nikolay-rogovoy/3x-CNC/проверка-спецификации.md

# Проверка спецификации v1.0

> **Архивный документ.** Замечания закрыты в спецификации v2.0. Решения этого документа по компонентам (MGN12, шпиндель Ø65, труба 80×40×4) заменены: актуальны `спецификация.md` и `чертёж-станка.dxf`.

**Дата:** 2026-11-07. Проверялась спецификация v1.0.

Как проверялось:

- **Расчёт** — посчитано по числам спецификации или модели чертежа.
- **Источник** — подтверждено каталогом или листингом (ссылки в конце).
- **Оценка** — инженерная оценка или данные по памяти; перед заказом сверить.

## A. Критично: станок в таком виде не собрать или он не выполнит требования

| # | Где | Проблема | На чертеже | Основание |
|---|---|---|---|---|
| A1 | §3.1 | Стойки разнесены на 260–300 мм, а стол шириной 300 мм: портал не пройдёт над столом | Просвет между стойками 400 мм | Расчёт |
| A2 | §8.1 п.2, 6, 8 | Балка 420 мм короче своего рельса 450 мм и винта 500 мм | Балка 480, рельс 450, винт ≈520 | Расчёт |
| A3 | §2, §3.1 | Габарит ~450×370 меньше собственной базы 520×340 и рельсов Y 500 мм | Габарит 588×621×577 мм | Расчёт по модели |
| A4 | §3.2, §8.1 п.8 | Один винт Y возможен только по центру, а поперечина к гайке под столом лишает стол опор на участке хода. Старый чертёж при этом показывал два винта | Два винта и два мотора Y, стол опирается на балки поз. 3 | Расчёт; решение на согласование |
| A5 | §3.3 | Балка 20×80 не проходит критерий 50 Н → ≤0,05 мм: профиль с открытыми пазами слабо работает на кручение. Кончик фрезы смещается примерно на **0,45 мм**, в 9 раз больше допуска. 40×80 тоже не проходит: ≈0,22 мм. Эпоксид или песок в полости это не исправят | Закрытая труба Al 80×40×4: ≈0,013 мм | Оценка (см. раздел D) |
| A6 | §2, §4.1, §5.3 | 800 Вт при 24 В — это 33 А, а заложено 15–20 А; БП 24 В 20 А даёт только 480 Вт | Шпиндель с ЧП 220 В | Расчёт |
| A7 | §4.1 | Выбранного шпинделя (DC 24 В, 800 Вт, Ø52–57, до 24 000 об/мин) в поиске не нашлось. Найдены два класса: 800 Вт, Ø65, 220 В с ЧП, до 24 000 об/мин; или Ø52, 48 В, 500 Вт, только 12 000 об/мин, что ниже нужных для плат 18 000–24 000 | Посадка диам. 65 | Источник (листинги) |
| A8 | §3.2, §8.1 п.10 | Муфты 5×5 и 5×8 не подходят: у NEMA 23 вал обычно 6,35 или 8 мм, а наборы SFU1605 с BK/BF комплектуются муфтой 6,35×10 | Муфта 8×10, размер уточнить по валу | Источник |
| A9 | §3.1, §3.2 | Параллельность ≤0,03 мм нереальна при установке рельса прямо на необработанный профиль и выверке «шаблоном и уровнем» | Посадочные полосы поз. 5, шлифовать или фрезеровать | Оценка |
| A10 | §3.3, §8.1 п.7 | Ось Z описана тремя способами: «1–2 рельса», «ШВП по обе стороны от шпинделя», «рельс + вал Ø20». Это противоречит и «единому решению MGN12», и BOM (1 рельс). Один рельс плохо держит кручение | 2 рельса, 4 каретки, винт между рельсами | Расчёт |

## B. Важно: исправить до заказа

| # | Где | Проблема | Рекомендация |
|---|---|---|---|
| B1 | §8.1 | **Ошибка суммы:** механика 42 600 ₽, а не 37 200 ₽. Итог по текущему BOM **82 700 ₽, а не 77 300 ₽** (Расчёт) | Исправить и пересчитать BOM под новую компоновку |
| B2 | §2 | Питание ≤1000 Вт не выполняется: 600 Вт + 800 Вт = 1400 Вт | Поднять лимит до ≈1,5 кВт, подобрать автомат |
| B3 | §5.1, §5.3 | 48 В и плата 6-Pack: по сообщению на форуме предел платы около 40 В, на шелкографии указано 9–24 В. Это не официальные данные | Проверить по вики платы; либо 36 В, либо внешние драйверы |
| B4 | §5.2, §8.3 | Момент моторов расходится: 1,2–2,2 Н·м и 2–3 Н·м. 1,9 Н·м — это уже корпус 76 мм (Источник). Данных по 57HS41 и 57HS56 не нашёл | Запросить паспорт; чертёж рассчитан на корпус 56 мм, для 76 мм добавить 20 мм к габариту |
| B5 | §5.2, §5.3 | TMC2209 не потянет NEMA 23 на 2,8–4 А: предел около 2 А RMS. У модулей TMC5160 предел тоже бывает около 3 А (Оценка) | Убрать альтернативу с TMC2209; сверить ток с модулем |
| B6 | §3.2, §8.1 | «SFU1605 + double-nut» — противоречие: двойная гайка это DFU, а «завальцованные» здесь не имеет смысла. Нашёл SFU1605 только как катаный C7; C5 не подтвердился. Цена ≈2200 ₽ за C5 выглядит заниженной | Выбрать DFU или SFU с преднатягом; определить реальный класс |
| B7 | §3.2, §8.1 п.5 | Рельс Y 500 мм избыточен: при 400 мм запас хода 254,6 мм на 200 мм поля (Расчёт). Каретки: «2 на сторону» и «4 на рельс» расходятся | Рельс 400, по 2 каретки на рельс |
| B8 | §3.1 | «20×80, паз 8» и «30×80»: у 20-й серии обычно паз 6, 30×80 в поиске не встретился. 40×80 с пазом 8 есть в каталоге | На чертеже 40×80 паз 8; сверить с поставщиком |
| B9 | §8.1 | BOM не соответствует конструкции: стойки 350 при нужных 221; нет поперечин базы; один винт Y; один рельс Z; 3 мотора и 3 драйвера | Обновить; список ниже |
| B10 | §8 | Дубли: два п.29, цанги в п.15 и п.16, материал стола в п.12 и п.31 | Перенумеровать, убрать дубли |
| B11 | §3.2 | У Z нет места под BF12: опора попала бы в плиту. На чертеже винт Z консольный, только BK12, длина ≈205 мм | Подтвердить решение. ШВП не самотормозит: при снятии питания проверить, не опускается ли голова |
| B12 | §2 | Масса по модели ≈41 кг (грубая оценка с запасом) — на границе лимита 35–40 кг | Уточнить после деталировки |

## C. Мелкие противоречия и текст

- Параллельность: ≤0,03 мм (§3.1) и ≤0,05 мм (§9).
- Биение: брак >0,02 мм (§2, §4.1), но в рисках >0,03 мм (§10).
- Жертвенный слой: 8 мм (§3.1) и 5 мм (§11).
- Обороты для плат: 18 000–24 000 и 15 000–25 000; для PETG: 6 000–12 000 и 8 000–15 000.
- Фреза для PETG: двухзаходная в §4.2, однозаходная в §8.2 п.19.
- Ускорение: рабочее 1000–2000 мм/с², но риск пропуска шагов выше 1500 мм/с².
- Резьба M6: нарезается только в алюминиевой плите, в МДФ — сквозные отверстия. Стол равен рабочему полю, места для струбцин вне поля нет.
- GRBL на Uno: при 1/32 и 2000 мм/мин нужно 42,7 кГц, это выше обычного предела около 30 кГц (Оценка). При 1/16 — 21,3 кГц.
- Непонятные или ошибочные формулировки: «автомат/ toreutic sourcing», «усечённые косынками», «запрессованные T-гайки», «манометром» (нужен индикатор), «alien адрес test», «gerboly», «авто прокачки», «накатка, лыски», «Фрезерованный стеклотекстолит».

**Проверено, ошибок нет:** шаги/мм 640 и 1280 (§9); 2000 мм/мин = 400 об/мин винта; критическая скорость винта 500 мм ≈7800 об/мин, большой запас; суммы §8.2, §8.3 и §8.4; пара BK12/BF12 для SFU1605.

## D. Расчёт жёсткости балки

Сила 50 Н, пролёт 440 мм, плечо от оси балки до кончика фрезы 178 мм, концы считаются жёстко заделанными. Податливость кареток, стоек и креплений не учтена, поэтому реальные значения будут хуже.

| Сечение | Кручение It, см⁴ | Смещение от кручения, мм | Изгиб по Y, мм |
|---|---|---|---|
| Профиль 20×80 | ≈1,5 (оценка) | **0,45** | 0,042 |
| Профиль 40×80 | ≈3 (оценка) | **0,22** | 0,009 |
| Труба Al 80×40×4 | 53,5 (формула Бредта) | **0,013** | 0,006 |

It для профилей оценён по близким каталожным данным: 20×40 паз 6 — 0,68 см⁴; R40/80 — 2,89 см⁴. Для точного расчёта нужен паспорт конкретного профиля. Порядок величин сомнений не вызывает: замкнутое сечение жёстче на кручение в десятки раз.

## E. Что поменять в BOM под новую компоновку

Цены заново не считались.

- **Добавить:** 1 винт Y с опорами и муфтой, 1 мотор, 1 драйвер, 1 рельс Z с каретками, ЧП к шпинделю, посадочные полосы, трубу 80×40×4, 2 балки стола и 2 поперечины базы.
- **Убрать:** БП 24 В 20 А, MOSFET-модуль шпинделя, 1 опору BF12.
- **Изменить:** профиль базы на 40×80, рельсы Y на 400 мм, длины винтов (Y ≈390, X ≈520, Z ≈205), муфты на 8×10 (или 6,35×10 под вал мотора).

Подключение ЧП также меняет §5.4–5.5: управление 0–10 В или RS-485 вместо ШИМ и MOSFET.

## F. Не проверено

- Размеры BK/BF12 и длина гайки DFU1605 (≈100 мм) взяты по памяти и неполным листингам. От них зависят длины винтов и габариты.
- Настройка двух моторов Y с выверкой по концевикам в FluidNC: поиск не дал подтверждения. Прочитать документацию FluidNC до заказа платы.
- Кронштейны гаек и хомуты показаны условно: это компоновка, а не рабочие чертежи деталей.
- DXF проверен только средствами ezdxf (аудит без ошибок, повторное чтение, отрисовка). В LibreCAD и AutoCAD файл не открывался.

## Источники

- MGN12H: [e-marat](https://e-marat.pl/product/mgn12-hz0hm-hiwin-linear-carriage-block), [DamenCNC](https://damencnc.com/en/hiwin-carriage-mgn-narrow-type-mgn-12-h-z0-hm-long/a1948)
- BK12/BF12 и SFU1605: [MakerStore BK12](https://www.makerstore.com.au/?p=102094), [MakerStore BF12](https://www.makerstore.com.au/?p=101741), [VEVOR, набор с муфтой 6,35×10](https://www.vevor.com/linear-guide-rail-c_10531/ball-screw-sfu1605-1200mm-bk-bf12-6-35-10mm-quality-cnc-set-high-efficiency-p_010944905805)
- ШВП: [SFU1605, листинг](https://vxb.com/products/sfu1605-ball-screw-nut-assembly-for-cnc-machines-1), [DFU, WFI](https://www.wfint.com.tw/Ball-Screw-DFU-Series-DIN69051/Custom-Ball-Screw.html)
- Плата 6-Pack, напряжение (форум): [forum.v1e.com](https://forum.v1e.com/t/custom-bart-dring-fluidnc-controller/38458?page=16); TMC5160: [Mouser](https://www.mouser.in/new/analog-devices/trinamic-tmc5160a-motor-controller-driver/)
- Профиль: [Alux 40×80, паз 8](https://www.aluxprofile.com/aluminium-slot-profile-4080/a3620), [item R40/80](https://uk-product.item24.com/en/directlink/pro/40914), [Rexroth, паз 6](https://www.directindustry.com/prod/bosch-rexroth-assembly-technology/product-127183-2537574.html)
- Моторы: [57HS76-2804](https://aws.robu.in/product/57hs76-2804-05-nema-23-18-9-kg-cm-hybrid-stepper-motor-d-type)
- Шпиндели: [800 Вт, ATO](https://www.ato.com/800w-air-cooled-cnc-spindle-motor), [65 мм, 800 Вт](https://vxb.com/products/65mm-800w-four-bearing-high-speed-electric-spindle), [52 мм, 500 Вт, 48 В](https://www.walmart.com/ip/12592002249)
