nikolay-rogovoy/3x-CNC/спецификация.md

# Спецификация DIY трёхосевого CNC-станка

**Дата:** 2026-11-08 · **Статус:** v2.2, соответствует чертежам `чертёж-станка.dxf` / `.pdf` (компоновка), `чертёж-стола.dxf` / `.pdf` (база со столом) и `чертёж-портала.dxf` / `.pdf` (портал с осями X и Z)

**Принцип подбора:** только массовые узлы, которые широко продаются и обычно ставятся на самодельные фрезеры. При выборе приоритет у качества и жёсткости, цена второстепенна.

---

## 1. Назначение

Настольный трёхосевой фрезер собственного изготовления для:

1. **Печатных плат:** изоляционная фрезеровка дорожек, сверление, вырезание контура.
2. **Пластика PETG:** контуры, карманы, гравировка, листы 2–10 мм.

Сталь и другие твёрдые металлы станку не по назначению. Алюминий возможен лёгкими проходами, но это не основная задача.

---

## 2. Целевые характеристики

Точность и повторяемость — цели приёмки, проверяются индикатором после сборки. Габариты и масса получены из модели чертежа.

| Параметр | Значение |
|---|---|
| Рабочее поле X×Y | **300 × 200 мм** |
| Рабочий ход Z | **60 мм** (механический предел 78 мм) |
| Габариты X×Y×Z | **608 × 653 × 614 мм** с моторами |
| Масса | ≈ 50 кг (оценка), поднимать вдвоём |
| Просвет под суппортом | ≈ 108 мм над столом; заготовка до 60 мм |
| Точность позиционирования | ± 0,05 мм / 100 мм |
| Повторяемость | ± 0,03 мм |
| Люфт по каждой оси | ≤ 0,02 мм |
| Разрешение | 0,0016 мм/шаг (микрошаг 1/16) |
| Холостой ход | ≥ 2000 мм/мин |
| Биение инструмента | ≤ 0,02 мм, измеряется на цанге с инструментом |
| Минимальная дорожка/зазор | реально 0,2–0,25 мм, конические фрезы 0,1–0,2 мм |
| Жёсткость | 50 Н на кончике фрезы → ≤ 0,05 мм |
| Питание | 220 В, автомат C16; потребление до ≈ 2,2 кВт |

---

## 3. Конструкция

Портал подвижный, стол неподвижный. Все длины рельсов и винтов заказываются в размер.

### 3.1 База

- **Профиль:** алюминиевый 40×80, паз 8, сплав 6060-T6 или 6063-T6 (AlMgSi), первичный. Минимум по паспорту: Iy ≥ 46 см⁴ (по высоте 80), Ix ≥ 12 см⁴. Лонжерон стоит высотой 80 вертикально: прогиб пролёта под 100 Н ≈ 0,008 мм, под 300 Н ≈ 0,025 мм.
- **Сердечники профиля:** канал Ø6,8 в 20 мм от граней, с 4 прорезями до Ø10,5. Резьбу M8 резать метчиком прямо в канал, без рассверливания: остаётся 65–70 % площади резьбы, этого хватает с запасом больше 2. Резьбовые вставки (Helicoil) не ставить: под них сверло 8,4, и от секторов почти ничего не остаётся.
- **Лонжероны (поз. 1):** 2 шт, L = 565 мм, разнесены на 440 мм по осям рельсов.
- **Поперечины (поз. 2.1, 2.2):** 2 шт, L = 400 мм, между лонжеронами. В задней 2.2 сквозные отверстия Ø32 под муфты винтов Y.
- **Балки стола (поз. 3):** 2 шт, L = 485 мм, между поперечинами, x = ±104…144 мм от оси станка. Винты Y (ось x = ±169) проходят снаружи от них, поэтому ничто не мешает опоре стола.
- **Угловые плиты (поз. 30, 31):** сталь 130×80×6, на торцах лонжеронов и поперечин, 2 + 2 шт. На задних плитах 31 стоят моторы Y: отверстие Ø39 под центрирующий буртик и 4×M5 по квадрату 47,14.
- **Плиты под опоры винтов Y (поз. 32):** сталь 64×80×6, 4 шт (2 обычные + 2 зеркальные). Нужны потому, что крепёжные отверстия BK12/BF12 стоят через 46 мм, а пазы профиля через 40 мм. Толщина 5,8…6,0 любая, но плиты одного винта шлифуются парно: разнотолщинность и разница в паре ≤ 0,02 мм. Плиты 30, 31 — холоднокатаный лист 6 h14, без шлифовки.
- **Опоры (поз. 24):** 4 регулируемые, Ø30, высота 15 мм, на T-гайках M8.
- **Соединения:** только винты в торцевые сердечники, без уголков. Клеёные и печатные несущие соединения запрещены.

| Узел | Крепёж | Резьба в торце | Кол-во |
|---|---|---|---|
| K1 лонжерон → торец поперечины | M8×55 DIN 912, 8.8, через Ø9 | глубина 15 | 8 |
| K2 поперечина → торец балки стола | M8×70 DIN 912, 8.8, через Ø9 | глубина 25 | 8 |
| K3 угловая плита → торец лонжерона | M8×20 DIN 912, 8.8 | глубина 15 | 8 |
| K4 угловая плита 30 → паз профиля | M6×12 + T-гайка M6 | — | 4 |

  Все M8 затягивать **12 Н·м** на фиксатор резьбы средней прочности. Торцы профиля фрезеровать в размер, неперпендикулярность ≤ 0,05 мм. Глубже 15 мм в лонжеронах и поперечинах резать нельзя: дальше поперечные отверстия Ø9 и Ø32. Полный перечень крепежа K1–K12 — в таблице на листе 1 чертежа стола.

### 3.2 Стол

- Сверху вниз: жертвенный МДФ 8 мм (поз. 4.3), МДФ 19 мм (поз. 4.2), алюминиевая плита 10 мм (поз. 4.1). Размер 300 × 200 мм, верх на высоте 132 мм.
- Плита 4.1 — литая прецизионная 5083 (ALCA 5, ALPLAN): поставляется фрезерованной с двух сторон, t ±0,1, плоскости не обрабатывать. Катаную 6082-T6 и 6063 не брать: первая без фрезеровки неровная, у второй слабая резьба M6.
- Плита 4.1 крепится к балкам 4 винтами M6 в T-гайки через зенкованные отверстия Ø6,6; МДФ к плите — 4 винтами M6×35 в резьбу плиты.
- Резьба M6 с шагом 50 мм нарезается только в алюминиевой плите, в МДФ сквозные отверстия с зенковкой.
- МДФ пропитать эпоксидной смолой или грунтом. После сборки фрезеровать жертвенный слой «на себя».

### 3.3 Оси и направляющие

Рельсы **HGR15** с каретками **HGH15CA** на всех осях: стандартный выбор для фрезеров, заметно жёстче MGN12 из 3D-принтеров. Предпочтительно Hiwin, допустимы проверенные аналоги.

| Ось | Рельсы | Каретки | Запас хода | Винт |
|---|---|---|---|---|
| Y | 2 × HGR15, L = 400 | 4, шаг 100 мм | 238,6 мм | **2** × DFU1605, L ≈ 395 |
| X | 2 × HGR15, L = 480, разнос 64 мм | 4, шаг 80 мм | 338,6 мм | 1 × DFU1605, L ≈ 520 |
| Z | 2 × HGR15, L = 220, разнос 110 мм | 4, шаг 80 мм | 78,6 мм | 1 × DFU1605, L ≈ 205 |

- **Посадка рельсов Y и X:** только на посадочные полосы из полосы 30×6 мм, шлифованные в 5,5 (разнотолщинность 0,01, полосы одной оси — в паре). Рельсы Z ставятся на обработанную плиту Z. На необработанный профиль рельс не ставить: ≤ 0,03 мм так не получить.
- **Параллельность рельсов:** ≤ 0,03 мм на всю длину, проверка индикатором.

### 3.4 Винты и опоры

- **ШВП:** DFU1605 с двойной гайкой и преднатягом, класс C7, торцы обработаны под BK12/BF12. C5 ставить, если найдётся по разумному сроку; на конструкцию это не влияет.
- **Опоры:** BK12 на приводном конце, BF12 на свободном (X и обе Y).
- **Ось Z:** только BK12, винт консольный. BF12 некуда поставить, а винт короткий. ШВП не самотормозит: при снятии питания проверить, что голова не опускается; если опускается, добавить тормоз или пружину.
- **Муфты:** лучевые алюминиевые **6,35×10 мм**, подобрать по фактическому валу мотора и хвостовику винта.
- **Кронштейны гаек:** фрезерованные из алюминия, 4 шт.
- **Смазка:** консистентная литиевая в винты и каретки, каждые 20–40 часов работы.

### 3.5 Портал

- **Балка X:** стальная **прямоугольная труба 100×50×4 мм** (ГОСТ 30245, Ст3сп), L = 480 мм. Паз профиля не держит кручение: при вылете фрезы профиль 20×80 и даже 40×80 не проходит критерий жёсткости, а замкнутая труба проходит. Сталь вместо алюминиевой трубы 100×50×5: дешевле, есть на любой металлобазе и в 2,6 раза жёстче на кручение; цена — +2,5 кг на ось Y (балка 4,3 кг вместо 1,8). Сварной шов трубы — на нижней стенке; грани под полосы 5.2 и плиты 19 проверить линейкой, неплоскостность > 0,1 — фрезеровать или подливка эпоксидной. Резьба M5 в стенке 4: плиты 19 крепить винтами M5×16 (под потай через Al 10 остаётся 6 мм резьбы).
- **Винт X:** над балкой. BK12 и мотор X стоят на плитах 19.1 и 19.3, BF12 — на плите 19.2. Плиты крепятся к верхней стенке трубы винтами M5 в резьбу.
- **Стойки (поз. 14):** профиль 40×80, 2 шт, L = 231 мм, смещены назад относительно центра кареток для уменьшения вылета.
- **Опоры портала (поз. 8 + 15):** сварной узел — плита 91×160 из стального листа 10 мм (после фрезеровки 9) и две щеки из стали 6 мм 160×100. Снаружи паза — сплошной шов катетом 6 с разделкой кромки щеки 30°×4. Внутри паза варить только перед стойкой (65 мм от переднего края): под стойкой шов занял бы углы паза, и стойка не села бы на плиту. После сварки фрезеруются низ плиты в t = 9 и паз 40 между щеками. Стойка стоит в пазу: снизу винт M8×20 DIN 7984 (низкая головка, цековка 5) в сердечник, сбоку 4 стяжки M8 через щёки и стойку.
- **Балка к стойкам:** с каждой стороны 2 винта M8×100 сзади через стойку и заднюю стенку трубы. Внутри трубы — гайка M8 DIN 985 с увеличенной шайбой DIN 9021 (Ø24, чтобы не продавить стенку 4 мм); гайку держат ключом на 13 через открытый торец трубы, отверстия в 20 мм от торца.
- **Порядок сборки опор:** плиту 8 крепят к кареткам Y до установки стойки, иначе 4 винта из 8 окажутся под стойкой.

### 3.6 Суппорт и узел Z

- **Суппорт X (поз. 22):** литая алюминиевая плита 5083, 200×292×20 мм, плоскости по поставке.
- **Почему не фрезеруем алюминий:** плиты 22, 26, 4.1 — из литой прецизионной плиты 5083 (ALCA 5, ALPLAN), она приходит фрезерованной с двух сторон: t ±0,1, плоскостность ≤ 0,05 на детали. Фрезеруются только стальные сварные детали, поэтому они нарисованы в толщине после обработки: из листа 10 — 9 (поз. 8, полка 16.1), стойка 16.1 из двух пластин 10 — 19.
- **Плита Z (поз. 26):** литая алюминиевая плита 5083, 180×240×20 мм, с окном под гайку и хвост винта. Рельсы Z на плите движутся вместе со шпинделем, каретки неподвижны на суппорте.
- **Рельсы Z разнесены на 150 мм** (±75). При меньшем расстоянии каретки Z перекрывают винты кареток X, и суппорт нельзя собрать. При 150 порядок такой: сначала каретки Z (винты с тыла суппорта), потом каретки X (винты спереди). Заодно выросла жёсткость Z на опрокидывание.
- **Кронштейны гаек:** Y (поз. 16.1) — сварной, целиком из стального листа 10 (стойка — пакет из двух пластин 40×97, сваренных по длинным кромкам; полка 60×34), висит под плитой 8 на полке с 4 винтами M6; после сварки фрезеруются верх полки в t = 9 и задняя грань под фланец гайки (стойка 19), затем сверлится Ø29 в 81,5 от верха полки; X (поз. 16.2) — брусок 40×83×40 из алюминиевого квадрата 40×40 (допустим пакет из 4 пластин Ал 10, стянутых винтами фланца), на тыльной грани суппорта над балкой, 4×M6; Ø28,5 по центру квадрата, фланец гайки — лысками вверх/вниз; Z (поз. 16.3) — за плитой Z, фланец гайки ложится на него сверху.
- **Вылет инструмента** от центра кареток Y: 217 мм.
- **Шпиндель:** 2 хомута Ø80 на плите Z, каждый из 3 колец Al 20 (120×110×20, свой разрез и стяжка M6, по 2 винта M6 к плите Z; Ø80 H7 растачивается в пакете колец одного хомута), перпендикулярность столу ≤ 0,05 мм/100 мм.

### 3.7 Расчётная жёсткость балки

Сила 50 Н, пролёт 440 мм, плечо до кончика фрезы 188 мм, концы заделаны жёстко. Податливость кареток, стоек и соединений не учтена, поэтому итог проверяется индикатором на собранном станке.

| Составляющая | Смещение, мм |
|---|---|
| Кручение балки | 0,002 |
| Изгиб по Y | 0,001 |
| Изгиб по Z | < 0,001 |

---

## 4. Шпиндель и инструмент

### 4.1 Шпиндель

**Шпиндель 1,5 кВт, Ø80 мм, 220 В, 400 Гц, 24 000 об/мин, цанга ER11, воздушное охлаждение**, 4 подшипника, в комплекте с частотным преобразователем.

- **Почему 1,5 кВт, а не меньше:** один из самых распространённых вариантов, продаётся готовым комплектом с ЧП, а мощность для PETG с запасом.
- **Почему воздух:** не нужны насос и шланги. Если шум окажется критичным, водяной шпиндель той же мощности тоже Ø80 и легко встаёт на эти хомуты, но проверить длину.
- **Масса:** ≈ 4–5 кг. На чертеже заложена длина 240 мм с запасом; сверить с покупным до изготовления хомутов.
- **На малых оборотах** момент падает, поэтому для PETG держать не ниже 8000 об/мин.
- **Цанги:** ER11 на 3,175, 4 и 6 мм, качественные. Перед работой проверить биение индикатором, браковать > 0,02 мм.

### 4.2 Инструмент (стартовый набор)

| Инструмент | Назначение |
|---|---|
| Конические фрезы 10°–30°, кончик 0,1–0,2 мм | Изоляция дорожек |
| Твердосплавные свёрла Ø0,8 / 1,0 / 1,2 мм | Отверстия THT/DIP |
| Кукурузная фреза Ø1,0–1,5 мм | Контур платы |
| V-фреза 30° / 60° | Гравировка |
| Однозаходная спиральная Ø2 / 3 мм | PETG: контуры и карманы |

### 4.3 Режимы (ориентир)

| Материал | Инструмент | Обороты | Подача, мм/мин | За проход, мм |
|---|---|---|---|---|
| Плата | Коническая 0,1–0,2 | 18 000–24 000 | 100–300 | 0,05–0,1 |
| Плата, сверление | Сверло 0,8–1,2 | 20 000–24 000 | 60–120 | 0,5–1 |
| PETG | Однозаходная Ø2 | 8 000–15 000 | 300–800 | 0,5–1,5 |

---

## 5. Электроника

### 5.1 Контроллер

- **FluidNC на плате 6-Pack** (ESP32), Wi-Fi и USB, настройка в YAML.
- Выходы шаг/направление на внешние драйверы через модули внешних драйверов для 6-Pack.
- Шпиндель через **RS-485-модуль** 6-Pack: управление, обратная связь по оборотам. Модуль нельзя ставить в гнездо 5.

### 5.2 Моторы и драйверы

| Ось | Мотор | Ток | Момент | Драйвер |
|---|---|---|---|---|
| X, Y1, Y2, Z | NEMA 23, корпус 76 мм, 4 шт | 2,8–3 А | ≈ 1,9 Н·м | **DM542T**, 4 шт |

- Микрошаг 1/16: 640 шагов/мм при винте с шагом 5 мм, 21,3 кГц при 2000 мм/мин.
- Два мотора Y работают как одна ось (ganged) с отдельным драйвером и датчиком на каждый.

### 5.3 Питание

| Потребитель | Источник |
|---|---|
| Моторы | **Mean Well SE-600-48**, 48 В, 12,5 А. **Выставить не выше 48 В:** выход регулируется до 56 В, а предел DM542T 50 В |
| Контроллер, датчики, реле | Mean Well 24 В, 2 А |
| Шпиндель | ЧП 1,5 кВт напрямую от 220 В |

На входе автомат C16, УЗО и заземление корпуса станка и шпинделя. Силовые кабели отдельно от сигнальных, кабель шпинделя экранированный, экран заземлён. Сетевой фильтр на входе ЧП.

### 5.4 Частотный преобразователь

- **Huanyang серии HY**, 1,5 кВт, 220 В, например HY01D523B. Серии FC01 избегать: есть сообщения о несовместимости с FluidNC.
- Настройки RS-485 на ЧП: скорость 9600, RTU 8N1, адрес по `modbus_id`. Параметры PD163–PD165 по вики модуля.
- **Сначала настроить ЧП по паспорту шпинделя и только потом подключать шпиндель.**

### 5.5 Периферия

- **Датчики дома:** 4 индуктивных: X, Y1, Y2, Z. Отдельные Y1 и Y2 обязательны для выверки портала. Ось Y должна идти в цикле дома отдельно от других осей.
- **Концы хода:** программные лимиты, на дальних концах механические упоры.
- **Щуп по Z:** контактная пластина с зажимом на фрезу, обязателен. Для плат обязательна также карта высот поверхности (autolevel).
- **Аварийный стоп:** грибковая кнопка на отдельном контуре.
- **Пылеудаление:** щётка-колпак и бытовой пылесос, включение через реле.

### 5.6 Схема

```
220 В ─ автомат C16 ─ УЗО ─┬─ фильтр ─ ЧП 1,5 кВт ─ шпиндель
                           ├─ БП 48 В ─ DM542T ×4 ─ NEMA 23 (X, Y1, Y2, Z)
                           └─ БП 24 В ─ FluidNC 6-Pack
                                         ├─ шаг/напр. ─ DM542T ×4
                                         ├─ RS-485 ─ ЧП
                                         ├─ датчики ×4, щуп, стоп
                                         ├─ реле ─ пылесос
                                         └─ Wi-Fi / USB ─ ПК
```

---

## 6. ПО

| Слой | Выбор |
|---|---|
| Контроллер | FluidNC |
| Отправка G-code | bCNC или веб-интерфейс FluidNC; bCNC удобен для карты высот |
| CAD | FreeCAD, Fusion 360 |
| CAM деталей | FreeCAD Path, Fusion 360 |
| CAM плат | KiCad → FlatCAM: изоляция, сверление, контур |
| Симуляция | CAMotics |

---

## 7. Прижим и пыль

- **Пыль плат вредна:** стеклотекстолит и медь. Пылесос обязателен, плюс респиратор и влажная уборка. Шпиндель воздушного охлаждения не должен сдувать пыль мимо колпака: проверить на первом проходе.
- **PETG:** при налипании стружки поднять подачу или снизить обороты; при необходимости обдув воздухом.
- **Прижим:** струбцины через сетку M6. Стол равен рабочему полю, поэтому прижимы занимают часть поля. Платы — на двусторонний скотч по выровненному МДФ.

---

## 8. Перечень комплектующих

Позиции совпадают с таблицей на чертеже там, где указан номер. Цены не приведены: смета v1.0 больше не действует, стоимость определяется запросом поставщикам.

### 8.1 Механика

| Поз. | Наименование | Размер | Кол-во |
|---|---|---|---|
| 1 | Лонжерон, профиль 40×80 паз 8 | L = 565 | 2 |
| 2.1 | Поперечина передняя, профиль 40×80 | L = 400 | 1 |
| 2.2 | Поперечина задняя, профиль 40×80, 2×Ø32 | L = 400 | 1 |
| 3 | Балка стола, профиль 40×80 | L = 485 | 2 |
| 14 | Стойка, профиль 40×80 | L = 232,5 | 2 |
| 17 | Балка X, труба стальная 100×50×4 | L = 480 | 1 |
| 5 | Полоса посадочная Y (полоса 30×6, шлиф.) | 400×30×5,5 | 2 |
| 5.2 | Полоса посадочная X (полоса 30×6, шлиф.) | 480×30×5,5 | 2 |
| 6 | Рельс HGR15, ось Y | L = 400 | 2 |
| 18 | Рельс HGR15, ось X | L = 480 | 2 |
| 27 | Рельс HGR15, ось Z | L = 220 | 2 |
| 7, 21, 25 | Каретка HGH15CA | | 12 |
| 9 | ШВП DFU1605 C7, ось Y | L ≈ 395 | 2 |
| 20 | ШВП DFU1605 C7, ось X | L ≈ 520 | 1 |
| 23 | ШВП DFU1605 C7, ось Z | L ≈ 205 | 1 |
| 10 | Опора BK12 | | 4 |
| 11 | Опора BF12 | | 3 |
| 12 | Муфта лучевая 6,35×10 | | 4 |
| 16.1 | Кронштейн гайки Y, сварной, сталь | 40×60×106 | 2 (1 + 1 зерк.) |
| 16.2 | Кронштейн гайки X, Al (квадрат 40×40) | 40×83×40 | 1 |
| 16.3 | Кронштейн гайки Z, Al | 100×26×30 | 1 |
| 8 | Плита опорная, сталь (лист 10, фрез.) | 91×160×9 | 2 |
| 15 | Щека, сталь (сварка с поз. 8) | 160×100×6 | 4 |
| 22 | Суппорт X, Al литая 5083 | 200×292×20 | 1 |
| 26 | Плита Z, Al литая 5083 | 180×240×20 | 1 |
| 19.1–19.4 | Плиты BK12 X, BF12 X, моторов X и Z | | 4 |
| 28 | Кольцо хомута шпинделя Ø80, Al 20 | 120×110×20 | 6 |
| 4.1 | Плита стола, Al литая 5083 | 300×200×10 | 1 |
| 4.2 | Плита МДФ | 300×200×19 | 1 |
| 4.3 | Жертвенный слой МДФ | 300×200×8 | 1 |
| 30 | Плита угловая передняя, сталь | 130×80×6 | 2 |
| 31 | Плита угловая задняя под мотор Y, сталь | 130×80×6 | 2 |
| 32 | Плита под BK12/BF12, сталь | 64×80×6 | 4 (2 + 2 зерк.) |
| 24 | Опора регулируемая | Ø30 | 4 |
| K1 | Винт M8×55 DIN 912, 8.8 | лонжерон — поперечина | 8 |
| K2 | Винт M8×70 DIN 912, 8.8 | поперечина — балка | 8 |
| K3 | Винт M8×20 DIN 912, 8.8 | плита — лонжерон | 8 |
| K4–K12 | Винты M4–M6, T-гайки M5/M6/M8 паз 8 | по таблице чертежа стола | компл. |
| — | Крепёж портала: перечень K1–K15 на листе 1 чертежа портала; фиксатор резьбы, смазка | | компл. |

### 8.2 Шпиндель и инструмент

| Поз. | Наименование | Кол-во |
|---|---|---|
| 29 | Шпиндель 1,5 кВт Ø80, ER11, воздух, 220 В | 1 |
| — | Цанги ER11: 3,175, 4, 6 мм | 3 |
| — | Инструмент по §4.2 | набор |

### 8.3 Электроника

| Наименование | Кол-во |
|---|---|
| Контроллер 6-Pack (FluidNC) | 1 |
| Модуль внешних драйверов для 6-Pack | по числу осей |
| Модуль RS-485 для 6-Pack | 1 |
| Мотор NEMA 23, 76 мм, 1,9 Н·м (поз. 13) | 4 |
| Драйвер DM542T | 4 |
| БП Mean Well SE-600-48 | 1 |
| БП Mean Well 24 В, 2 А | 1 |
| ЧП Huanyang серии HY, 1,5 кВт, 220 В | 1 |
| Датчик индуктивный | 4 |
| Щуп по Z: пластина и зажим | 1 |
| Кнопка аварийного стопа | 1 |
| Реле, автомат C16, УЗО, сетевой фильтр | компл. |
| Кабель экранированный, разъёмы, кабель-каналы | компл. |
| Корпус электроники с вентиляцией | 1 |

### 8.4 Пылеудаление

| Наименование | Кол-во |
|---|---|
| Щётка-колпак, шланг | 1 компл. |
| Бытовой пылесос | 1 |

---

## 9. Порядок сборки

1. **База:** фрезеровать торцы профилей, нарезать M8 в сердечниках (15 мм, в балках 25 мм). Собрать раму на K1, затем балки на K2, угловые плиты на K3/K4; M8 — 12 Н·м на фиксатор. Выставить на опорах, плоскостность ≤ 0,1 мм на 400 мм. Порядок и размеры — по чертежу стола.
2. **Рельсы Y:** установить полосы, обработать, поставить рельсы. Параллельность ≤ 0,03 мм.
3. **Портал:** по чертежу портала, лист 1, п. 2. Проверить перпендикулярность балки к рельсам Y и лёгкость хода руками.
4. **Рельсы X и суппорт:** установить полосы и рельсы на балку.
5. **Винты:** поставить опоры, кронштейны, муфты. Каждую ось прокрутить вручную без заеданий по всей длине.
6. **Узел Z:** собрать, закрепить шпиндель, проверить перпендикулярность столу ≤ 0,05 мм/100 мм.
7. **ЧП:** настроить по паспорту шпинделя, затем подключить шпиндель и проверить вращение и направление.
8. **Электроника:** питание, контроллер, драйверы, датчики. Первый запуск без инструмента.
9. **FluidNC:** 640 шагов/мм при 1/16, скорость, ускорение. Настроить выверку Y: Y идёт в цикле дома отдельно.
10. **Калибровка:** биение индикатором, фрезеровка жертвенного слоя, проверка шагов по эталону, люфта и жёсткости (50 Н).
11. **Первый тест:** плата 20×20 мм: изоляция с картой высот, сверление, контур.
12. **Деталь PETG:** квадрат 30 мм, замерить штангенциркулем.

---

## 10. Риски

| Риск | Последствие | Что делать |
|---|---|---|
| Биение шпинделя > 0,02 мм | Рвутся дорожки | Заменить цангу; если не помогло, менять шпиндель по гарантии |
| Неровность платы | Неравномерная глубина | Фрезеровать стол на себя, карта высот обязательна |
| Перекос портала | Косые углы, заедание | Выверка по двум датчикам, настройка смещения Y2 |
| Помехи от ЧП | Сбои контроллера, датчиков | Экранированный кабель, заземление, фильтр, раздельная прокладка |
| Перенапряжение DM542T | Выход драйвера из строя | БП не выше 48 В |
| Просадка МДФ от влаги | Потеря плоскостности | Пропитка, не мыть стол |
| Пыль плат | Вред здоровью, замыкания | Пылесос, респиратор, влажная уборка |

---

## 11. Расходники

- Запасные конические фрезы 0,1 мм, 10 шт: ломаются быстро.
- Жертвенный слой МДФ 8 мм.
- Смазка винтов и кареток.
- Провод и зажимы щупа.

---

## 12. Что проверить до заказа

Решения приняты, но эти данные не подтверждены первоисточником:

- [ ] Длина и посадочные размеры гайки DFU1605. На чертеже 100 мм с запасом; нашёл 80 мм для исполнения DFU1605-3. Если короче, винты можно укоротить.
- [ ] Чертёж HGH15CA: длина указана как 60,5 и 61,4 мм; на чертеже заложено 61,4.
- [ ] Чертёж выбранного шпинделя: общая длина и зона посадки.
- [ ] Наличие и совместимость модулей внешних драйверов для 6-Pack.
- [ ] Вал выбранного мотора (6,35 или 8 мм) и размер муфты.
- [ ] Схема подключения индуктивных датчиков к входам 6-Pack.
- [ ] Наличие компрессора: обдув при PETG не обязателен.
- [ ] Наличие 3D-принтера для щётки-колпака и держателей датчиков.
