nikolay-rogovoy/3x-CNC/(list of files, cad)

Other CAD files:
чертёж-станка.dxf
чертёж-портала.dxf
чертёж-стола.dxf
