nikolay-rogovoy/3x-CNC/чертёж-станка.pdf

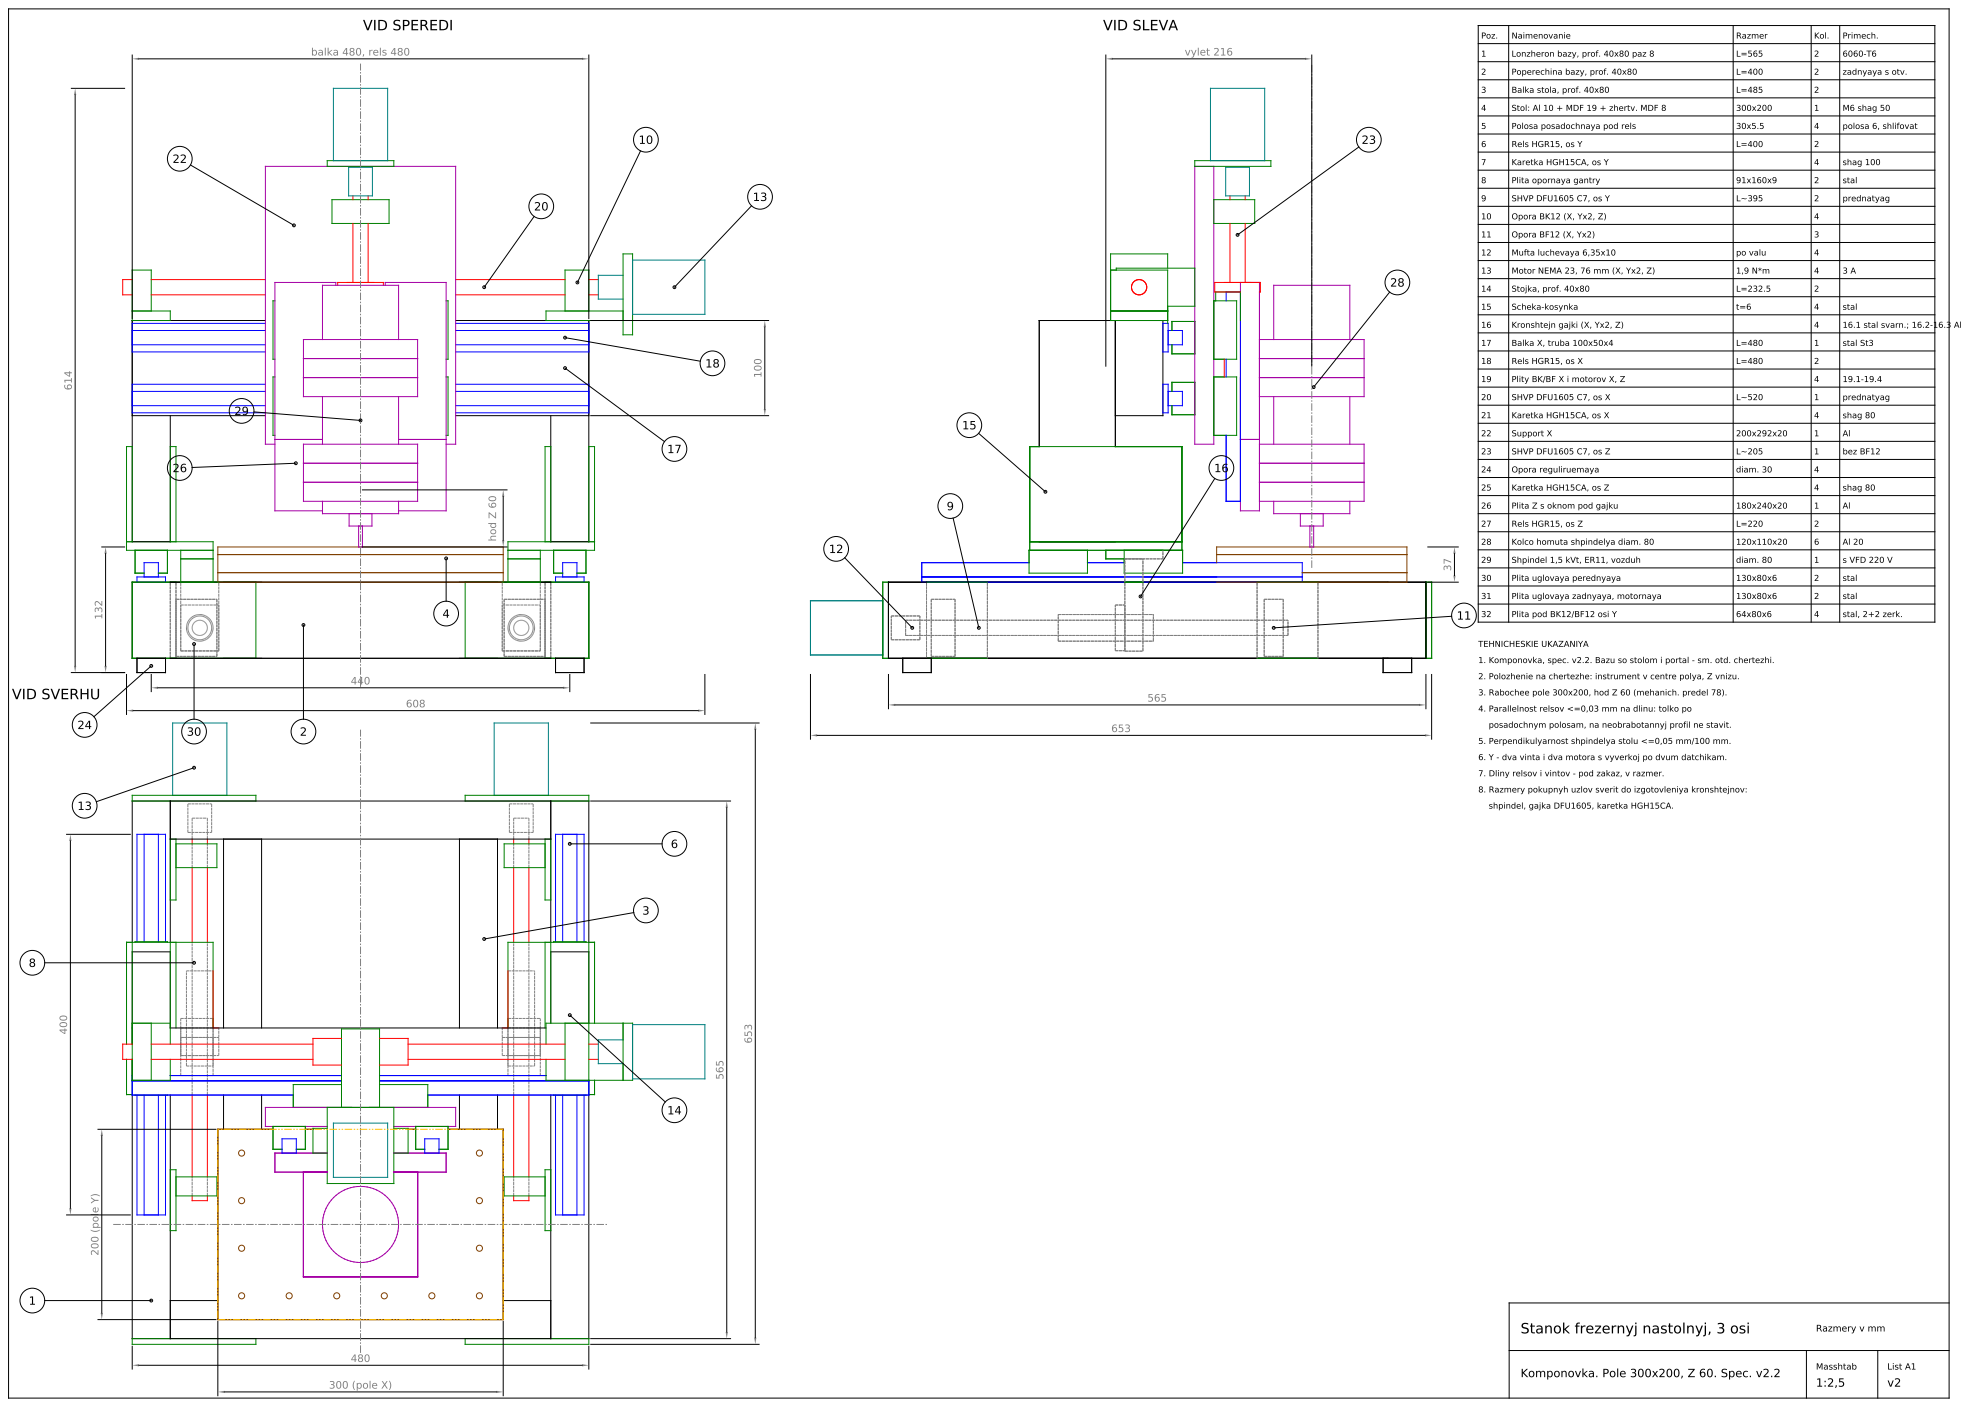
[picture p4: page 1]
