nikolay-rogovoy/3x-CNC/чертёж-стола.pdf

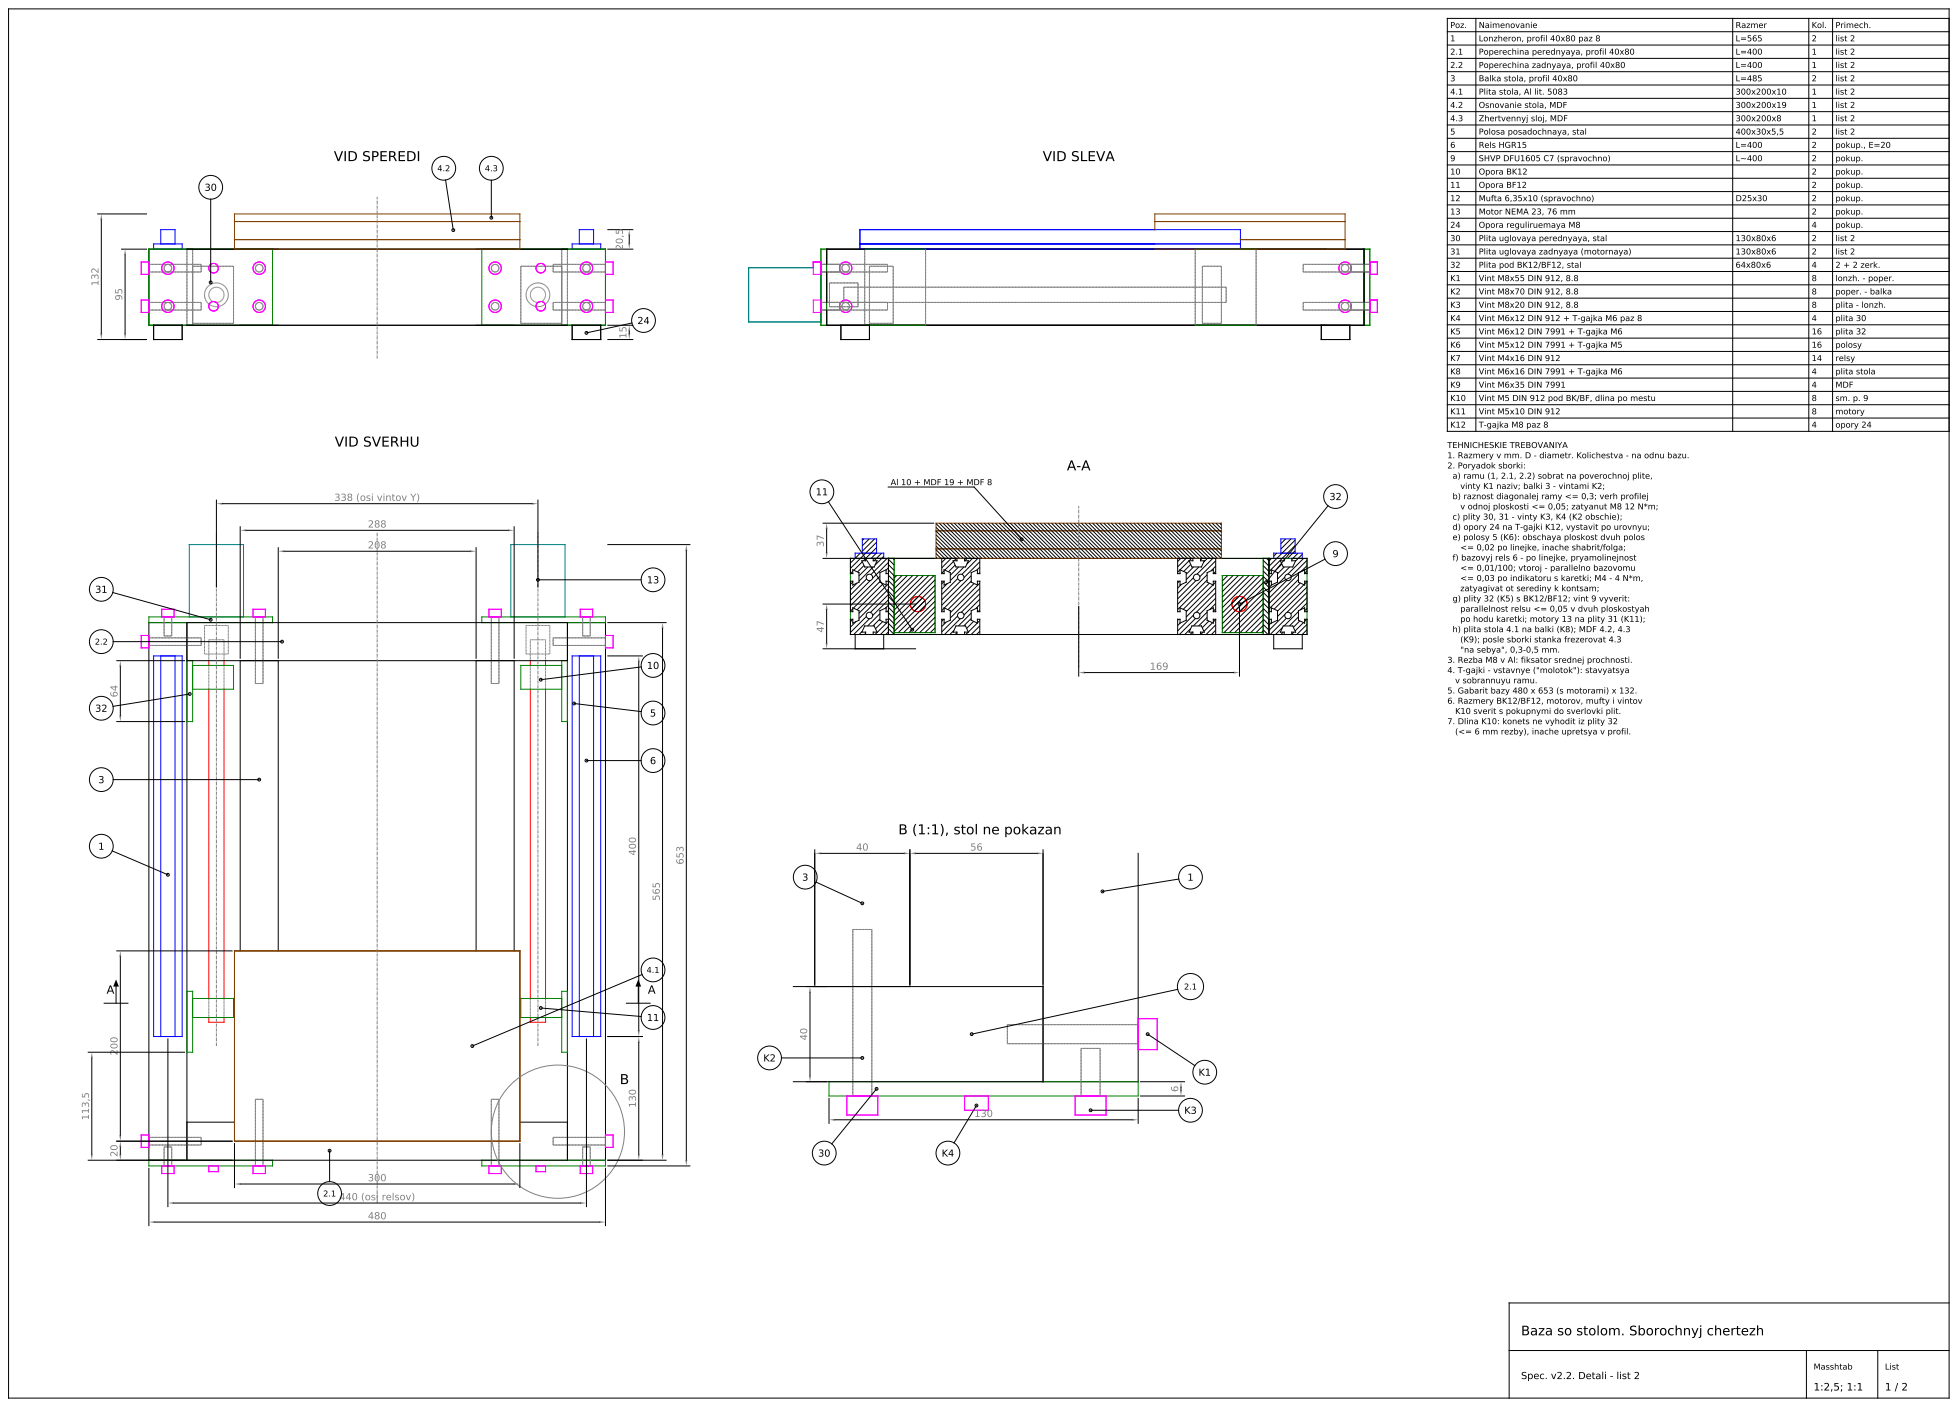
[picture p5: page 1]

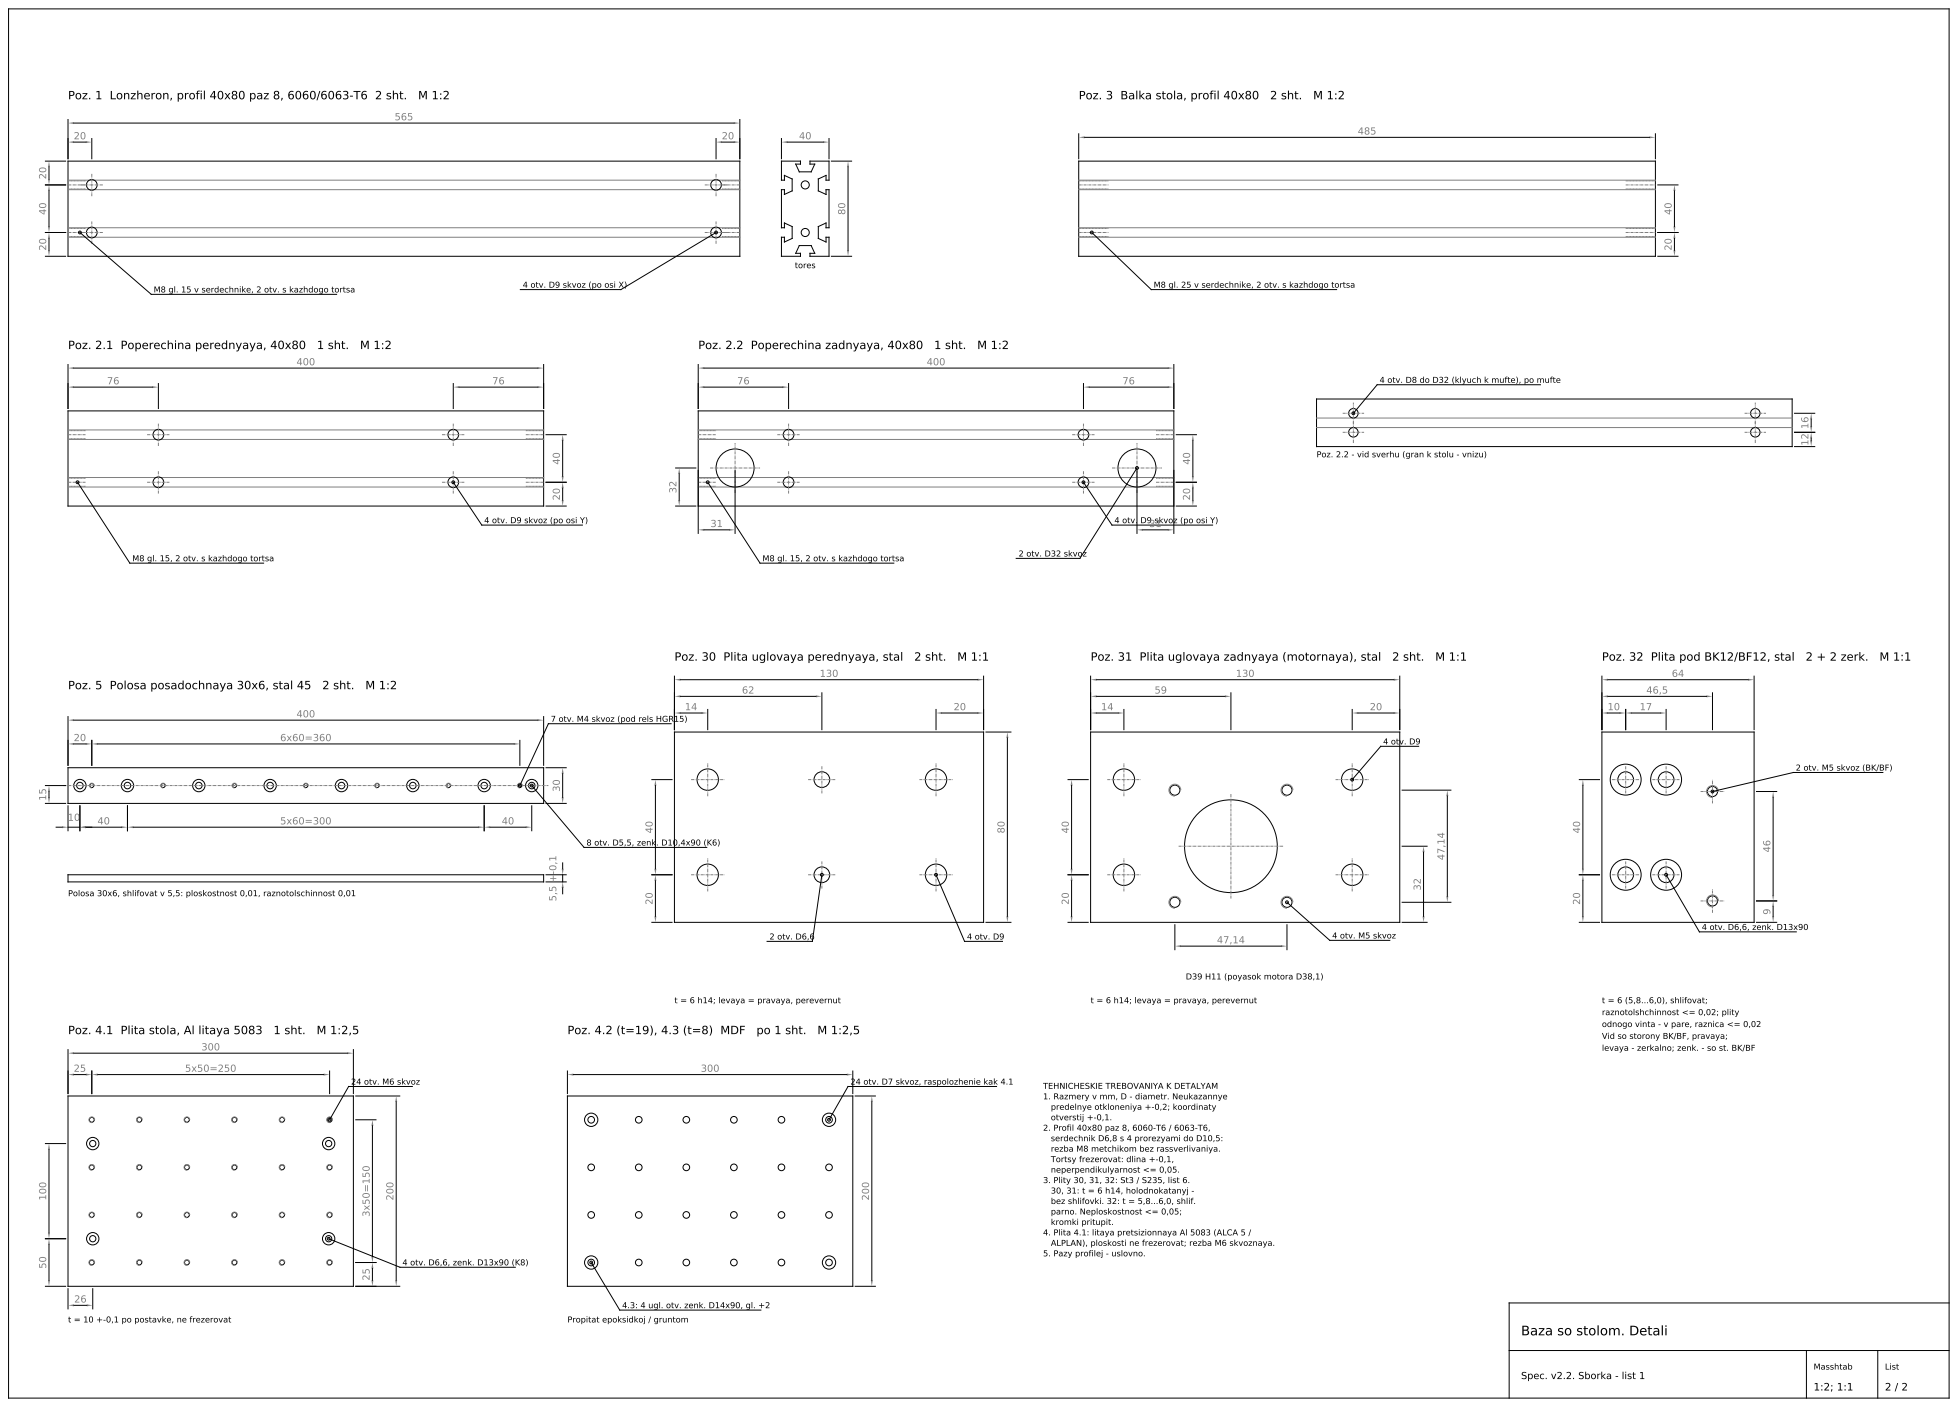
[picture p6: page 2]
