nikolay-rogovoy/3x-CNC/(commit log)

2026-11-08 Спецификация v2.1, чертёж сборки базы со столом
    - чертёж-стола.dxf/.pdf: сборочный чертёж базы и стола (лист 1)
    и детали с размерами (лист 2): лонжероны, поперечины, балки,
    полосы, плиты 30/31/32, стол 4.1-4.3, крепёж K1-K12
    - чертёж станка: плиты 30/31/32, ось винтов Y ±169, габарит Y 653,
    ступенчатый кронштейн гайки Y
    - размерный текст крупный и с натуральными значениями для LibreCAD
    - спецификация v2.1: профиль 6060/606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
    [чертёж-станка-cp1251.dxf, чертёж-станка.dxf, чертёж-стола.dxf]
2026-11-08 Убрать из репозитория резервную копию LibreCAD
    [#чертёж-станка.dxf]
2026-11-08 Чертёж портала с осями X и Z, спецификация v2.2
    - чертёж-портала.dxf/.pdf: сборка портала (лист 1), крупные детали
    1:2 (лист 2: балка, стойка, полоса X, суппорт, плита Z), мелкие
    детали 1:1 (лист 3: опора, щека, кронштейны гаек, плиты 19.x,
    планка, хомут), крепёж K1-K14 и порядок сборки
    - рельсы Z разнесены на 150: иначе каретки Z закрывают винты
    кареток X и суппорт не собрать; суппорт 200x292, плита Z 180x240
    - разрабо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
    [чертёж-портала.dxf, чертёж-станка.dxf, чертёж-стола.dxf]
2026-11-08 Сварной кронштейн гайки Y (16.1), уточнение сварки щёк опоры портала
    - 16.1: сварной стальной (Ст3), фрезеровка после сварки
    - Щёки 15 к плите 8: снаружи сплошной шов катет 6 с разделкой 30x4,
    внутри паза только перед стойкой, под стойкой не варить
    - Обновлены чертежи станка и портала, спецификация
    [чертёж-портала.dxf, чертёж-станка.dxf]
2026-11-08 Кронштейн гайки X (16.2) из квадрата 40x40, L 83; выноска 12 на виде спереди
    - 16.2: брусок 40x83x40 вместо 60x87x58, Ø28,5 по центру квадрата,
    допускается пакет из 4 пластин Al 10; отверстия C суппорта ±12, z 153/177
    - Выноски муфт 12 (X и Z) перенесены на вид спереди
    - Спецификация и таблицы обновлены
    [чертёж-портала.dxf, чертёж-станка.dxf]
2026-11-08 Опорная плита портала (поз. 8) из стали 10 вместо 15
    - Плита 8: 91x160x10; стойка 14 удлинена до 231 (верх портала без изменений),
    отверстия K1 в стойке 156/206
    - K3: M8x20 DIN 7984, цековка D14 гл. 5; K4: M4x10, цековка гл. 4,5
    - K12 разделён: M6x20 для 16.1, новый K15 M6x25 для 16.2, 16.3
    - Спецификация и чертежи обновлены
    [чертёж-портала.dxf, чертёж-станка.dxf]
2026-11-08 Хомуты шпинделя из колец Al 20, гайки K1 вместо планки 33, выноски 25/27
    - Поз. 28: 6 колец 120x110x20 (2 хомута по 3), у каждого свой разрез,
    стяжка M6 (K14) и 2xM6 к плите Z (K13, 12 шт.); D80 H7 растачивать в пакете;
    отверстия F плиты Z: 12 шт., z 20/40/60/130/150/170
    - Поз. 33 убрана: K1 M8x100 + гайка DIN 985 + шайба DIN 9021 внутри трубы
    - Вид слева: 25 указывает на обе каретки Z, 27 - на рельс под каретками
    - Спецификация обновлена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
    [чертёж-портала.dxf, чертёж-станка.dxf]
2026-11-08 Выноска 16.3 указывает на кронштейн гайки Z, а не на каретку
    [чертёж-портала.dxf]
2026-11-09 Стальная балка X 100x50x4, толщины стальных деталей после фрезеровки
    - Балка 17: стальная труба 100x50x4 (ГОСТ 30245) вместо Al 100x50x5,
    жёсткость на кручение x2,6; плиты 19.1/19.2 на M5x16 (K7 18, K8 11).
    - Сталь нарисована в размере после обработки: плита 8 и полка 16.1 —
    лист 10 -> 9; стойка 16.1 — 2 пластины 10 -> 19, D29 в 81,5 от верха;
    полосы 5/5.2 — 30x6 шлифовать в 5,5; стойка 14 L=232,5.
    - Плиты 22, 26, 4.1 — литая 5083, плоскости не фрезеров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
    [чертёж-портала.dxf, чертёж-станка.dxf, чертёж-стола.dxf]
